phosphide/ZLL_Lights/Hardware/Standard/ZigbeeLightController_RevA1_bom.xlsx

Ref | Value | Footprint | Notes | Part number | Mouser reference
C1 | 1u | Capacitors_SMD:C_0805 | > 6V, X?R | GRM21BR71C105KA01L | 81-GRM40X105K16L
C2 | 1u | Capacitors_SMD:C_0805 | > 6V, X?R | GRM21BR71C105KA01L | 81-GRM40X105K16L
C3 | 100n | Capacitors_SMD:C_0603 | anything will do | 06033C104KAT2A | 581-06033C104KAT2A
C4 | 2.2u | Capacitors_SMD:C_1206 | > 40 V, X?R | UMK316B7225KL-T | 963-UMK316B7225KL-T
C5 | 10u | Capacitors_SMD:C_1206 | > 6V, X?R | GRM319R61E106KA12D | 81-GRM319R61E106KA2D
C6 | 100n | Capacitors_SMD:C_0603 | anything will do | 06033C104KAT2A | 581-06033C104KAT2A
C7 | 10u | Capacitors_SMD:C_1206 | > 6V, X?R | GRM319R61E106KA12D | 81-GRM319R61E106KA2D
C8 | 470n | Capacitors_SMD:C_0603 | anything will do | TMK107BJ474KA-T | 963-TMK107BJ474KA-T
C9 | 100n | Capacitors_SMD:C_0603 | anything will do | 06033C104KAT2A | 581-06033C104KAT2A
C10 | 100n | Capacitors_SMD:C_0603 | anything will do | 06033C104KAT2A | 581-06033C104KAT2A
C11 | 100n | Capacitors_SMD:C_0603 | anything will do | 06033C104KAT2A | 581-06033C104KAT2A
C12 | 100n | Capacitors_SMD:C_0603 | anything will do | 06033C104KAT2A | 581-06033C104KAT2A
C13 | 100n | Capacitors_SMD:C_0603 | anything will do | 06033C104KAT2A | 581-06033C104KAT2A
C14 | 100n | Capacitors_SMD:C_0603 | anything will do | 06033C104KAT2A | 581-06033C104KAT2A
C15 | 100n | Capacitors_SMD:C_0603 | anything will do | 06033C104KAT2A | 581-06033C104KAT2A
C16 | 100n | Capacitors_SMD:C_0603 | anything will do | 06033C104KAT2A | 581-06033C104KAT2A
C17 | 100n | Capacitors_SMD:C_0603 | anything will do | 06033C104KAT2A | 581-06033C104KAT2A
C18 | 100n | Capacitors_SMD:C_0603 | anything will do | 06033C104KAT2A | 581-06033C104KAT2A
C19 | 100n | Capacitors_SMD:C_0603 | anything will do | 06033C104KAT2A | 581-06033C104KAT2A
C20 | 100n | Capacitors_SMD:C_0603 | anything will do | 06033C104KAT2A | 581-06033C104KAT2A
C21 | 2.2u | Capacitors_SMD:C_1206 | > 40 V, X?R | UMK316B7225KL-T | 963-UMK316B7225KL-T
D1 | 1N4148 | Diodes_SMD:D_SOD-123 | any 1N4148 will do | 1N4148W-TP | 833-1N4148W-TP
D2 | NSR0340HT1G | Diodes_SMD:D_SOD-323 |  | NSR0340HT1G | 863-NSR0340HT1G
D3 | LED | zll_lib:D_0805_LED | can substitute, but may need to update R23 and footprint | LG R971-KN-1 | 720-LGR971-KN-1
D4 | SMAJ28A-E3/61 | Diodes_SMD:D_SMA |  | SMAJ28A-E3/61 | 625-SMAJ28A-E3
J1 | M20-7870346 | see datasheet |  | M20-7870346 | 855-M20-7870346
J2 | 1935268 | see datasheet |  | 1935268 | 651-1935268
J3 | 1935268 | see datasheet |  | 1935268 | 651-1935268
J4 | 1935161 | see datasheet |  | 1935161 | 651-1935161
L1 | 22u | Inductors_SMD:L_Taiyo-Yuden_NR-50xx |  | NRS5020T220MMGJ | 963-NRS5020T220MMGJ
Q1 | 2N7002 | TO_SOT_Packages_SMD:SOT-23 | anything will do | 2N7002P,215 | 771-2N7002P-215
Q2 | 2N7002 | TO_SOT_Packages_SMD:SOT-23 | anything will do | 2N7002P,215 | 771-2N7002P-215
Q3 | FDMS7682 | zll_lib:Power56_Vias |  | FDMS7682 | 512-FDMS7682
Q4 | FDMS7682 | zll_lib:Power56_Vias |  | FDMS7682 | 512-FDMS7682
Q5 | FDMS7682 | zll_lib:Power56_Vias |  | FDMS7682 | 512-FDMS7682
Q6 | FDMS7682 | zll_lib:Power56_Vias |  | FDMS7682 | 512-FDMS7682
Q7 | FDMS7682 | zll_lib:Power56_Vias |  | FDMS7682 | 512-FDMS7682
Q8 | FDMS7682 | zll_lib:Power56_Vias |  | FDMS7682 | 512-FDMS7682
Q9 | FDMS7682 | zll_lib:Power56_Vias |  | FDMS7682 | 512-FDMS7682
Q10 | FDMS7682 | zll_lib:Power56_Vias |  | FDMS7682 | 512-FDMS7682
Q11 | FDMS7682 | zll_lib:Power56_Vias |  | FDMS7682 | 512-FDMS7682
Q12 | FDMS7682 | zll_lib:Power56_Vias |  | FDMS7682 | 512-FDMS7682
Q13 | FDMS7682 | zll_lib:Power56_Vias |  | FDMS7682 | 512-FDMS7682
Q14 | FDMS7682 | zll_lib:Power56_Vias |  | FDMS7682 | 512-FDMS7682
R1 | 10k | Resistors_SMD:R_0603 | anything will do | RC0603FR-0710KL | 603-RC0603FR-0710KL
R2 | 10k | Resistors_SMD:R_0603 | anything will do | RC0603FR-0710KL | 603-RC0603FR-0710KL
R3 | 52.3k | Resistors_SMD:R_0603 | must be < 1% | AC0603FR-0752K3L | 603-AC0603FR-0752K3L
R4 | 10k | Resistors_SMD:R_0603 | must be < 1% | RC0603FR-0710KL | 603-RC0603FR-0710KL
R5 | 4.7k | Resistors_SMD:R_0603 | anything will do | RC0603JR-074K7L | 603-RC0603JR-074K7L
R6 | 4.7k | Resistors_SMD:R_0603 | anything will do | RC0603JR-074K7L | 603-RC0603JR-074K7L
R7 | 18k | Resistors_SMD:R_0603 | anything will do | RC0603JR-0718KL | 603-RC0603JR-0718KL
R8 | 4.7k | Resistors_SMD:R_0603 | anything will do | RC0603JR-074K7L | 603-RC0603JR-074K7L
R9 | 4.7k | Resistors_SMD:R_0603 | anything will do | RC0603JR-074K7L | 603-RC0603JR-074K7L
R10 | 8.2 | Resistors_SMD:R_0603 | anything will do | RC0603JR-078R2L | 603-RC0603JR-078R2L
R11 | 8.2 | Resistors_SMD:R_0603 | anything will do | RC0603JR-078R2L | 603-RC0603JR-078R2L
R12 | 8.2 | Resistors_SMD:R_0603 | anything will do | RC0603JR-078R2L | 603-RC0603JR-078R2L
R13 | 8.2 | Resistors_SMD:R_0603 | anything will do | RC0603JR-078R2L | 603-RC0603JR-078R2L
R14 | 8.2 | Resistors_SMD:R_0603 | anything will do | RC0603JR-078R2L | 603-RC0603JR-078R2L
R15 | 8.2 | Resistors_SMD:R_0603 | anything will do | RC0603JR-078R2L | 603-RC0603JR-078R2L
R16 | 8.2 | Resistors_SMD:R_0603 | anything will do | RC0603JR-078R2L | 603-RC0603JR-078R2L
R17 | 8.2 | Resistors_SMD:R_0603 | anything will do | RC0603JR-078R2L | 603-RC0603JR-078R2L
R18 | 8.2 | Resistors_SMD:R_0603 | anything will do | RC0603JR-078R2L | 603-RC0603JR-078R2L
R19 | 8.2 | Resistors_SMD:R_0603 | anything will do | RC0603JR-078R2L | 603-RC0603JR-078R2L
R20 | 8.2 | Resistors_SMD:R_0603 | anything will do | RC0603JR-078R2L | 603-RC0603JR-078R2L
R21 | 8.2 | Resistors_SMD:R_0603 | anything will do | RC0603JR-078R2L | 603-RC0603JR-078R2L
R22 | 10k | Resistors_SMD:R_0603 | anything will do | RC0603FR-0710KL | 603-RC0603FR-0710KL
R23 | 330 | Resistors_SMD:R_0603 | anything will do | RC0603JR-07330RL | 603-RC0603JR-07330RL
R24 | 10k | Resistors_SMD:R_0603 | anything will do | RC0603FR-0710KL | 603-RC0603FR-0710KL
R25 | 10k | Resistors_SMD:R_0603 | anything will do | RC0603FR-0710KL | 603-RC0603FR-0710KL
R26 | 10k | Resistors_SMD:R_0603 | anything will do | RC0603FR-0710KL | 603-RC0603FR-0710KL
R27 | 10k | Resistors_SMD:R_0603 | anything will do | RC0603FR-0710KL | 603-RC0603FR-0710KL
R28 | 10k | Resistors_SMD:R_0603 | anything will do | RC0603FR-0710KL | 603-RC0603FR-0710KL
R29 | 10k | Resistors_SMD:R_0603 | anything will do | RC0603FR-0710KL | 603-RC0603FR-0710KL
R30 | 10k | Resistors_SMD:R_0603 | anything will do | RC0603FR-0710KL | 603-RC0603FR-0710KL
R31 | 10k | Resistors_SMD:R_0603 | anything will do | RC0603FR-0710KL | 603-RC0603FR-0710KL
R32 | 10k | Resistors_SMD:R_0603 | anything will do | RC0603FR-0710KL | 603-RC0603FR-0710KL
R33 | 10k | Resistors_SMD:R_0603 | anything will do | RC0603FR-0710KL | 603-RC0603FR-0710KL
R34 | 10k | Resistors_SMD:R_0603 | anything will do | RC0603FR-0710KL | 603-RC0603FR-0710KL
R35 | 10k | Resistors_SMD:R_0603 | anything will do | RC0603FR-0710KL | 603-RC0603FR-0710KL
SW1 | SW_Push | zll_lib:PTS645SM43SMTR_92_LFS | can substitute, but may need to update footprint | PTS645SM43SMTR 92 LFS | 611-PTS645SM43SMTR92
TH1 | NTCG163JH103JT1 | Resistors_SMD:R_0603 | can substitute, but may need to update calibration in firmware | NTCG163JH103JT1 | 810-NTCG163JH103JT1
U1 | MCP16301 | TO_SOT_Packages_SMD:SOT-23-6 |  | MCP16301 | 579-MCP16301HT-E/CH
U2 | AP2120N-3.3 | TO_SOT_Packages_SMD:SOT-23 |  | AP2120N-3.3TRG1 | 621-AP2120N-3.3TRG1
U3 | JN5168-001-M00 | zll_lib:JN5168-001 |  | JN5168-001-M00Z | 771-JN5168-001-M00Z
U4 | PCA9685 | zll_lib:TSSOP-28 |  | PCA9685PW,118 | 771-PCA9685PW,118
U5 | ZXGD3009DY | TO_SOT_Packages_SMD:SOT-363_SC-70-6 |  | ZXGD3009DYTA | 621-ZXGD3009DYTA
U6 | ZXGD3009DY | TO_SOT_Packages_SMD:SOT-363_SC-70-6 |  | ZXGD3009DYTA | 621-ZXGD3009DYTA
U7 | ZXGD3009DY | TO_SOT_Packages_SMD:SOT-363_SC-70-6 |  | ZXGD3009DYTA | 621-ZXGD3009DYTA
U8 | ZXGD3009DY | TO_SOT_Packages_SMD:SOT-363_SC-70-6 |  | ZXGD3009DYTA | 621-ZXGD3009DYTA
U9 | ZXGD3009DY | TO_SOT_Packages_SMD:SOT-363_SC-70-6 |  | ZXGD3009DYTA | 621-ZXGD3009DYTA
U10 | ZXGD3009DY | TO_SOT_Packages_SMD:SOT-363_SC-70-6 |  | ZXGD3009DYTA | 621-ZXGD3009DYTA
U11 | ZXGD3009DY | TO_SOT_Packages_SMD:SOT-363_SC-70-6 |  | ZXGD3009DYTA | 621-ZXGD3009DYTA
U12 | ZXGD3009DY | TO_SOT_Packages_SMD:SOT-363_SC-70-6 |  | ZXGD3009DYTA | 621-ZXGD3009DYTA
U13 | ZXGD3009DY | TO_SOT_Packages_SMD:SOT-363_SC-70-6 |  | ZXGD3009DYTA | 621-ZXGD3009DYTA
U14 | ZXGD3009DY | TO_SOT_Packages_SMD:SOT-363_SC-70-6 |  | ZXGD3009DYTA | 621-ZXGD3009DYTA
U15 | ZXGD3009DY | TO_SOT_Packages_SMD:SOT-363_SC-70-6 |  | ZXGD3009DYTA | 621-ZXGD3009DYTA
U16 | ZXGD3009DY | TO_SOT_Packages_SMD:SOT-363_SC-70-6 |  | ZXGD3009DYTA | 621-ZXGD3009DYTA
