phosphide/ZLL_Lights/Hardware/Standard/ZigbeeLightController.kicad_pcb

## KiCad design Hardware/Standard/ZigbeeLightController.kicad_pcb (2018-05-30)

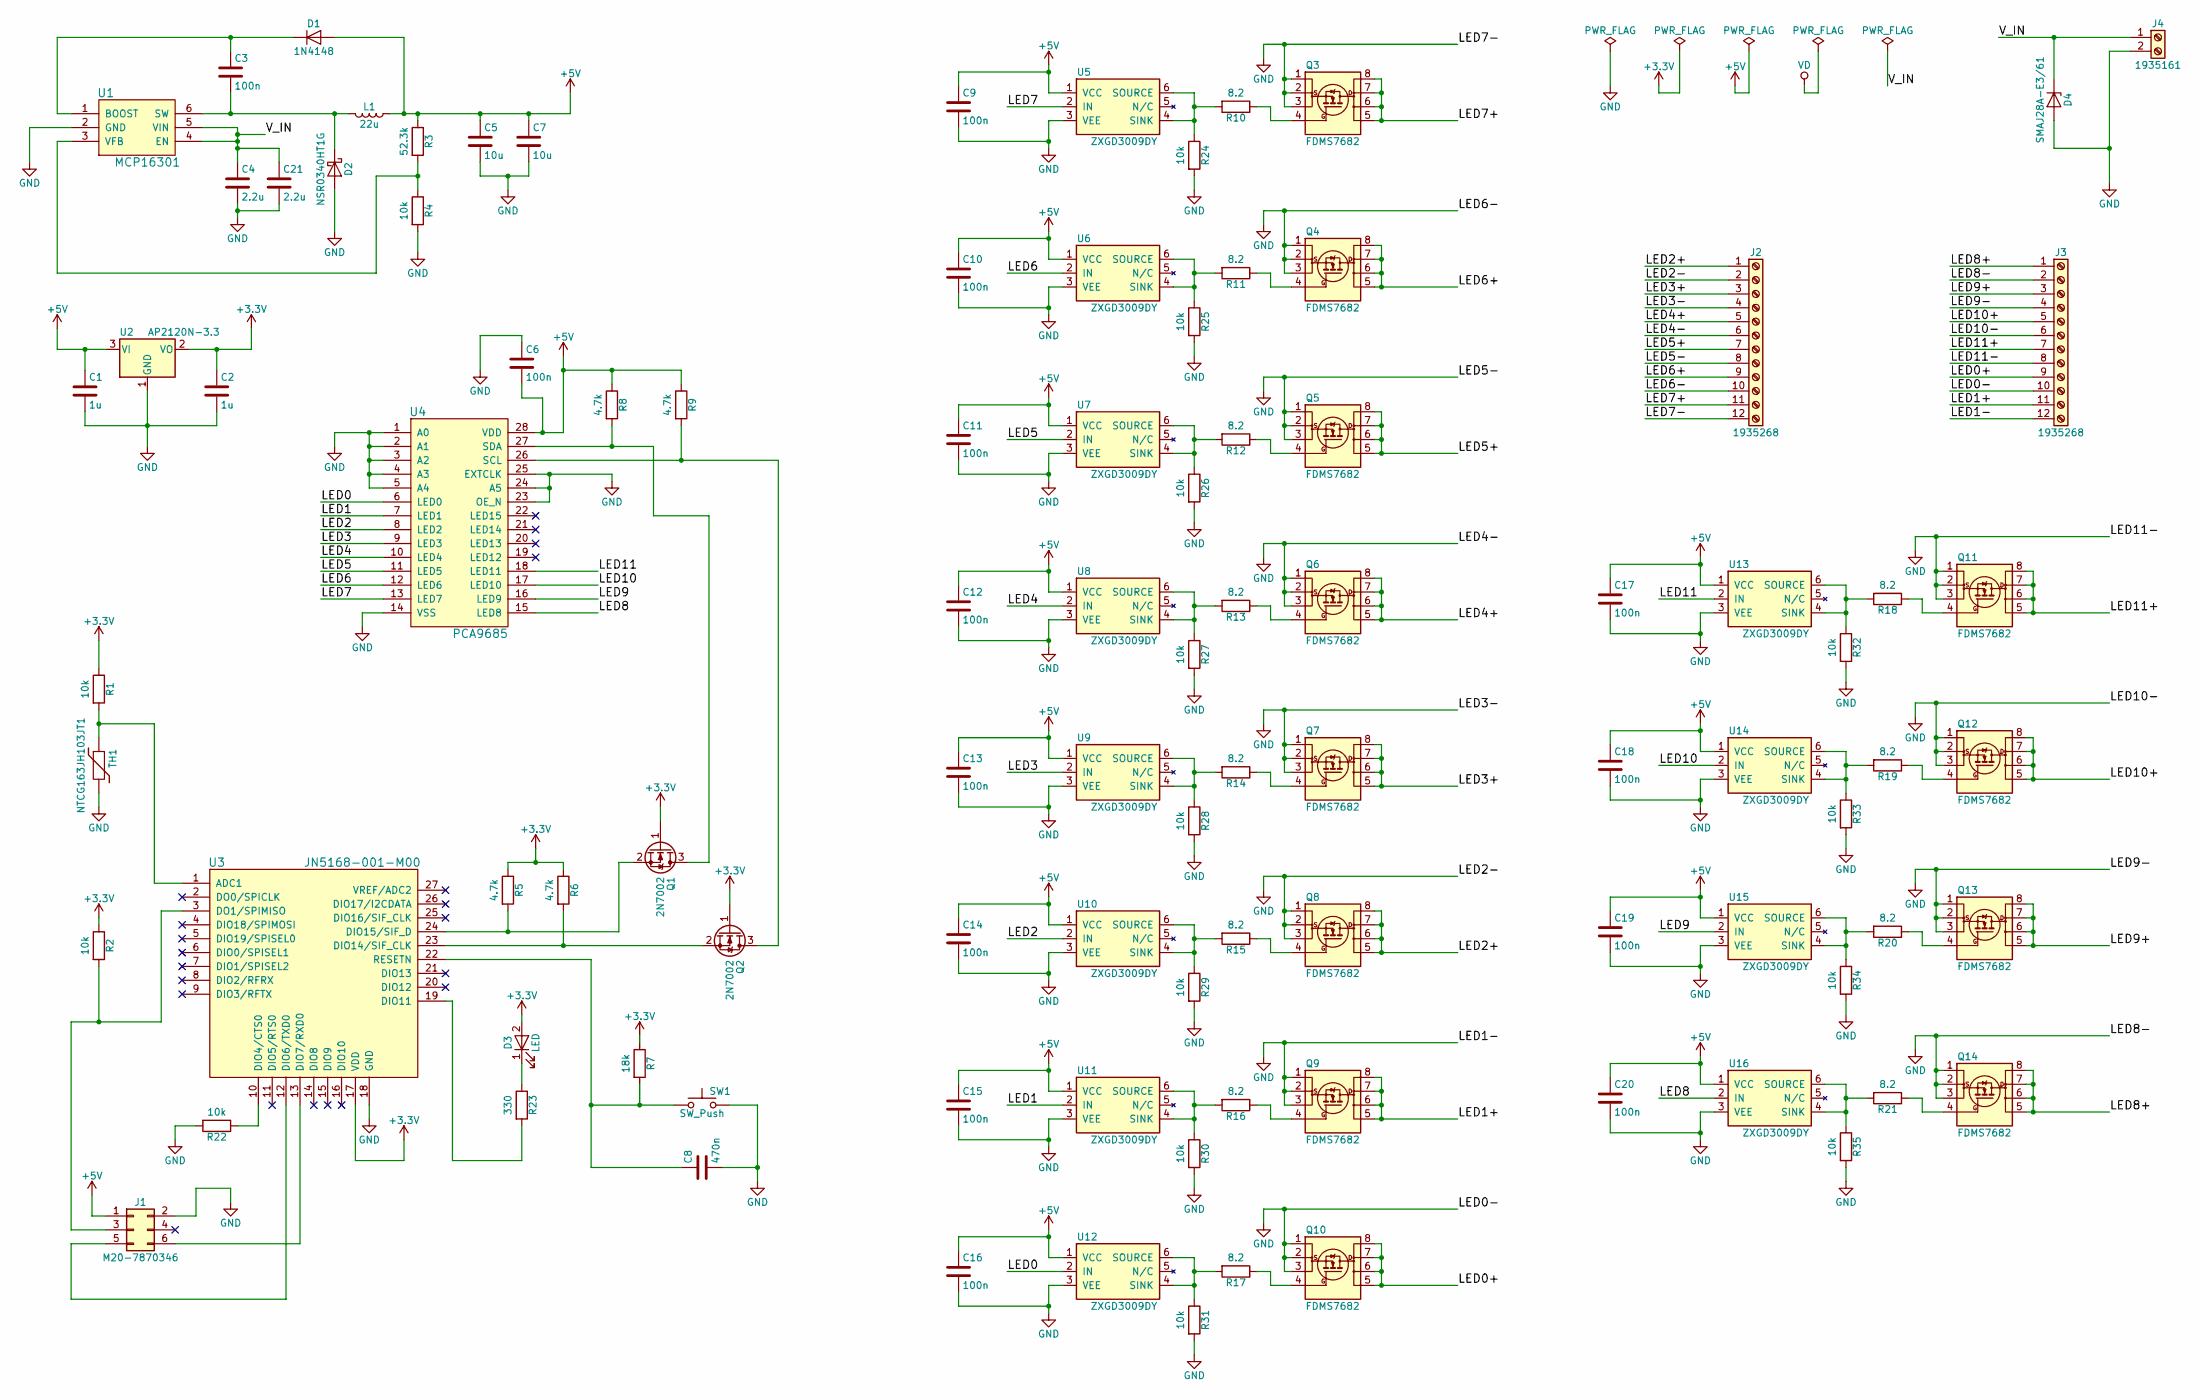
[picture p1: schematic ZigbeeLightController.sch, Zigbee Light Controller]

Parts:
C1, C2: 1u; C_0805
C3, C6, C9, C10, C11, C12, C13, C14, C15, C16, C17, C18, C19, C20: 100n; C_0603
C4, C21: 2.2u; C_1206
C5, C7: 10u; C_1206
C8: 470n; C_0603
D1: 1N4148; D_SOD-123
D2: NSR0340HT1G; D_SOD-323
D3: LED; D_0805_LED
D4: SMAJ28A-E3/61; D_SMA
J1: M20-7870346; Pin_Header_Straight_2x03_Pitch2.54mm_SMD
J2, J3: 1935268; TerminalBlock_Philmore_TB13x_12x5mm_Straight
J4: 1935161; TerminalBlock_Philmore_TB132_02x5mm_Straight
L1: 22u; L_Taiyo-Yuden_NR-50xx
Q1, Q2: 2N7002; SOT-23
Q3, Q4, Q5, Q6, Q7, Q8, Q9, Q10, Q11, Q12, Q13, Q14: FDMS7682; Power56_Vias
R1, R2, R4, R22, R24, R25, R26, R27, R28, R29, R30, R31, R32, R33, R34, R35: 10k; R_0603
R3: 52.3k; R_0603
R5, R6, R8, R9: 4.7k; R_0603
R7: 18k; R_0603
R10, R11, R12, R13, R14, R15, R16, R17, R18, R19, R20, R21: 8.2; R_0603
R23: 330; R_0603
SW1: SW_Push; PTS645SM43SMTR_92_LFS
TH1: NTCG163JH103JT1; R_0603
U1: MCP16301; SOT-23-6
U2: AP2120N-3.3; SOT-23
U3: JN5168-001-M00; JN5168-001
U4: PCA9685; TSSOP-28
U5, U6, U7, U8, U9, U10, U11, U12, U13, U14, U15, U16: ZXGD3009DY; SOT-363_SC-70-6

Connections:
+3V3: C2.1, D3.2 (A), Q1.1 (G), Q2.1 (G), R1.1, R2.1, R5.1, R6.1, R7.1, U2.2 (VO), U3.17 (VDD); also elsewhere on the board
+5V: C1.1, C5.1, C6.2, C7.1, C9.1, C10.1, C11.1, C12.1, C13.1, C14.1, C15.1, C16.1, C17.1, C18.1, C19.1, C20.1, D1.2 (A), J1.1, L1.1, R3.1, R8.1, R9.1, U2.3 (VI), U4.28 (VDD), U5.1 (VCC), U6.1 (VCC), U7.1 (VCC), U8.1 (VCC), U9.1 (VCC), U10.1 (VCC), U11.1 (VCC), U12.1 (VCC), U13.1 (VCC), U14.1 (VCC), U15.1 (VCC), U16.1 (VCC); also elsewhere on the board
/LED0: U4.6 (LED0), U12.2 (IN)
/LED0+: J3.9, Q10.5 (D), Q10.6 (D), Q10.7 (D), Q10.8 (D)
/LED1: U4.7 (LED1), U11.2 (IN)
/LED1+: J3.11, Q9.5 (D), Q9.6 (D), Q9.7 (D), Q9.8 (D)
/LED2: U4.8 (LED2), U10.2 (IN)
/LED2+: J2.1, Q8.5 (D), Q8.6 (D), Q8.7 (D), Q8.8 (D)
/LED3: U4.9 (LED3), U9.2 (IN)
/LED3+: J2.3, Q7.5 (D), Q7.6 (D), Q7.7 (D), Q7.8 (D)
/LED4: U4.10 (LED4), U8.2 (IN)
/LED4+: J2.5, Q6.5 (D), Q6.6 (D), Q6.7 (D), Q6.8 (D)
/LED5: U4.11 (LED5), U7.2 (IN)
/LED5+: J2.7, Q5.5 (D), Q5.6 (D), Q5.7 (D), Q5.8 (D)
/LED6: U4.12 (LED6), U6.2 (IN)
/LED6+: J2.9, Q4.5 (D), Q4.6 (D), Q4.7 (D), Q4.8 (D)
/LED7: U4.13 (LED7), U5.2 (IN); also elsewhere on the board
/LED7+: J2.11, Q3.5 (D), Q3.6 (D), Q3.7 (D), Q3.8 (D)
/LED8: U4.15 (LED8), U16.2 (IN)
/LED8+: J3.1, Q14.5 (D), Q14.6 (D), Q14.7 (D), Q14.8 (D)
/LED9: U4.16 (LED9), U15.2 (IN); also elsewhere on the board
/LED9+: J3.3, Q13.5 (D), Q13.6 (D), Q13.7 (D), Q13.8 (D)
/LED10: U4.17 (LED10), U14.2 (IN)
/LED10+: J3.5, Q12.5 (D), Q12.6 (D), Q12.7 (D), Q12.8 (D)
/LED11: U4.18 (LED11), U13.2 (IN)
/LED11+: J3.7, Q11.5 (D), Q11.6 (D), Q11.7 (D), Q11.8 (D)
/V_IN: C4.1, C21.1, D4.1 (K), J4.1, U1.4 (EN), U1.5 (VIN)
GND: C1.2, C2.2, C4.2, C5.2, C6.1, C7.2, C8.2, C9.2, C10.2, C11.2, C12.2, C13.2, C14.2, C15.2, C16.2, C17.2, C18.2, C19.2, C20.2, C21.2, D2.2 (A), D4.2 (A), J1.2, J2.2, J2.4, J2.6, J2.8, J2.10, J2.12, J3.2, J3.4, J3.6, J3.8, J3.10, J3.12, J4.2, Q3.1 (S), Q3.2 (S), Q3.3 (S), Q4.1 (S), Q4.2 (S), Q4.3 (S), Q5.1 (S), Q5.2 (S), Q5.3 (S), Q6.1 (S), Q6.2 (S), Q6.3 (S), Q7.1 (S), Q7.2 (S), Q7.3 (S), Q8.1 (S), Q8.2 (S), Q8.3 (S), Q9.1 (S), Q9.2 (S), Q9.3 (S), Q10.1 (S), Q10.2 (S), Q10.3 (S), Q11.1 (S), Q11.2 (S), Q11.3 (S), Q12.1 (S), Q12.2 (S), Q12.3 (S), Q13.1 (S), Q13.2 (S), Q13.3 (S), Q14.1 (S), Q14.2 (S), Q14.3 (S), R4.2, R22.2, R24.2, R25.2, R26.2, R27.2, R28.2, R29.2, R30.2, R31.2, R32.2, R33.2, R34.2, R35.2, SW1.2, TH1.2, U1.2 (GND), U2.1 (GND), U3.18 (GND), U4.1 (A0), U4.2 (A1), U4.3 (A2), U4.4 (A3), U4.5 (A4), U4.14 (VSS), U4.23 (OE_N), U4.24 (A5), U4.25 (EXTCLK), U5.3 (VEE), U6.3 (VEE), U7.3 (VEE), U8.3 (VEE), U9.3 (VEE), U10.3 (VEE), U11.3 (VEE), U12.3 (VEE), U13.3 (VEE), U14.3 (VEE), U15.3 (VEE), U16.3 (VEE); also elsewhere on the board
unnamed: C3.1, D1.1 (K), U1.1 (BOOST)
unnamed: C3.2, D2.1 (K), L1.2, U1.6 (SW)
unnamed: C8.1, R7.2, SW1.1, U3.22 (RESETN)
unnamed: D3.1 (K), R23.1
unnamed: J1.3, R2.2, U3.3 (DO1/SPIMISO)
unnamed: J1.5, U3.12 (DIO6/TXD0)
unnamed: J1.6, U3.13 (DIO7/RXD0)
unnamed: Q1.2 (S), R5.2, U3.24 (DIO15/SIF_D)
unnamed 37: Q1.3 (D), R8.2, U4.27 (SDA); also elsewhere on the board
unnamed: Q2.2 (S), R6.2, U3.23 (DIO14/SIF_CLK)
unnamed 39: Q2.3 (D), R9.2, U4.26 (SCL); also elsewhere on the board
unnamed: Q3.4 (G), R10.1
unnamed: Q4.4 (G), R11.1
unnamed: Q5.4 (G), R12.1
unnamed: Q6.4 (G), R13.1
unnamed: Q7.4 (G), R14.1
unnamed: Q8.4 (G), R15.1
unnamed: Q9.4 (G), R16.1
unnamed: Q10.4 (G), R17.1
unnamed: Q11.4 (G), R18.1
unnamed: Q12.4 (G), R19.1
unnamed: Q13.4 (G), R20.1
unnamed: Q14.4 (G), R21.1
unnamed: R1.2, TH1.1, U3.1 (ADC1)
unnamed: R3.2, R4.1, U1.3 (VFB)
unnamed: R10.2, R24.1, U5.4 (SINK), U5.6 (SOURCE)
unnamed: R11.2, R25.1, U6.4 (SINK), U6.6 (SOURCE)
unnamed: R12.2, R26.1, U7.4 (SINK), U7.6 (SOURCE)
unnamed: R13.2, R27.1, U8.4 (SINK), U8.6 (SOURCE)
unnamed: R14.2, R28.1, U9.4 (SINK), U9.6 (SOURCE)
unnamed: R15.2, R29.1, U10.4 (SINK), U10.6 (SOURCE)
unnamed: R16.2, R30.1, U11.4 (SINK), U11.6 (SOURCE)
unnamed: R17.2, R31.1, U12.4 (SINK), U12.6 (SOURCE)
unnamed: R18.2, R32.1, U13.4 (SINK), U13.6 (SOURCE)
unnamed: R19.2, R33.1, U14.4 (SINK), U14.6 (SOURCE)
unnamed: R20.2, R34.1, U15.4 (SINK), U15.6 (SOURCE)
unnamed: R21.2, R35.1, U16.4 (SINK), U16.6 (SOURCE)
unnamed: R22.1, U3.10 (DIO4/CTS0)
unnamed: R23.2, U3.19 (DIO11)

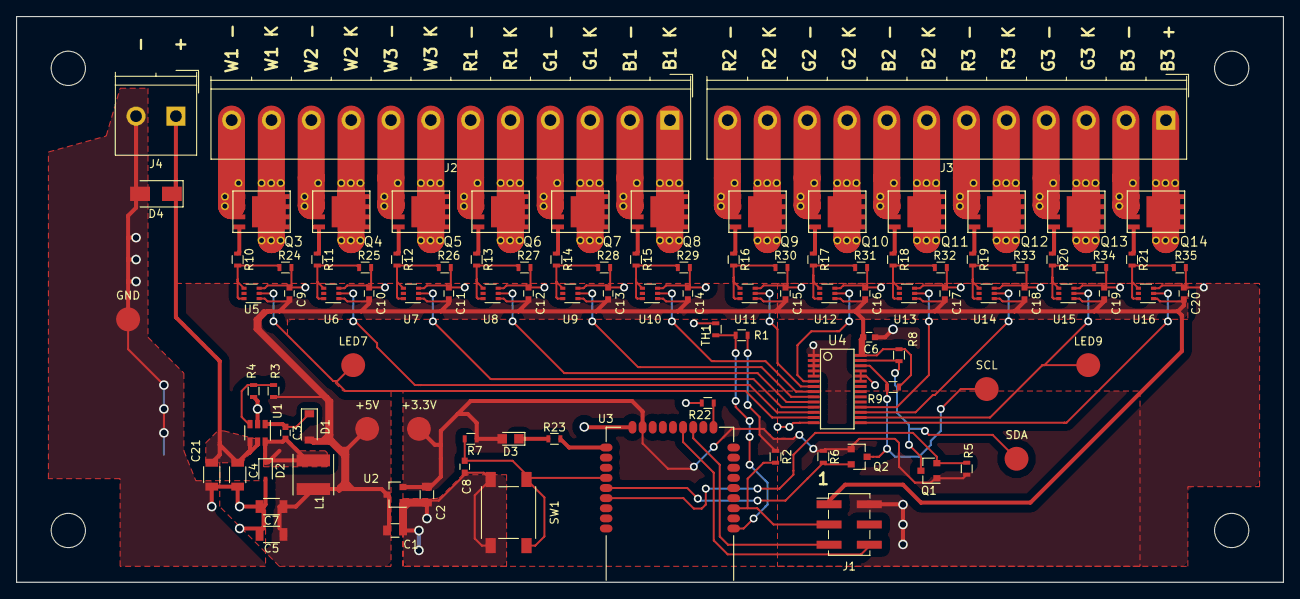
[picture p2: board ZigbeeLightController.kicad_pcb from above]

Board: 2 copper layers, 159.0 x 71.0 mm, 104 parts (0 on the bottom side), 67 nets.

Other parts of the board:
+3.3V, +5V: Measurement_Point_Round-SMD-Pad_Big
GND: Measurement_Point_Round-SMD-Pad_Big
LED7, LED9: Measurement_Point_Round-SMD-Pad_Big
SCL: Measurement_Point_Round-SMD-Pad_Big
SDA: Measurement_Point_Round-SMD-Pad_Big

Their connections:
+3V3: +3.3V.1; also elsewhere on the board
+5V: +5V.1; also elsewhere on the board
/LED7: LED7.1; also elsewhere on the board
/LED9: LED9.1; also elsewhere on the board
GND: GND.1; also elsewhere on the board
unnamed 37: SDA.1; also elsewhere on the board
unnamed 39: SCL.1; also elsewhere on the board
