phosphide/ZLL_Lights/Hardware/Mini/ZigbeeLightControllerMini.kicad_pcb

## KiCad design Hardware/Mini/ZigbeeLightControllerMini.kicad_pcb (2018-05-30)

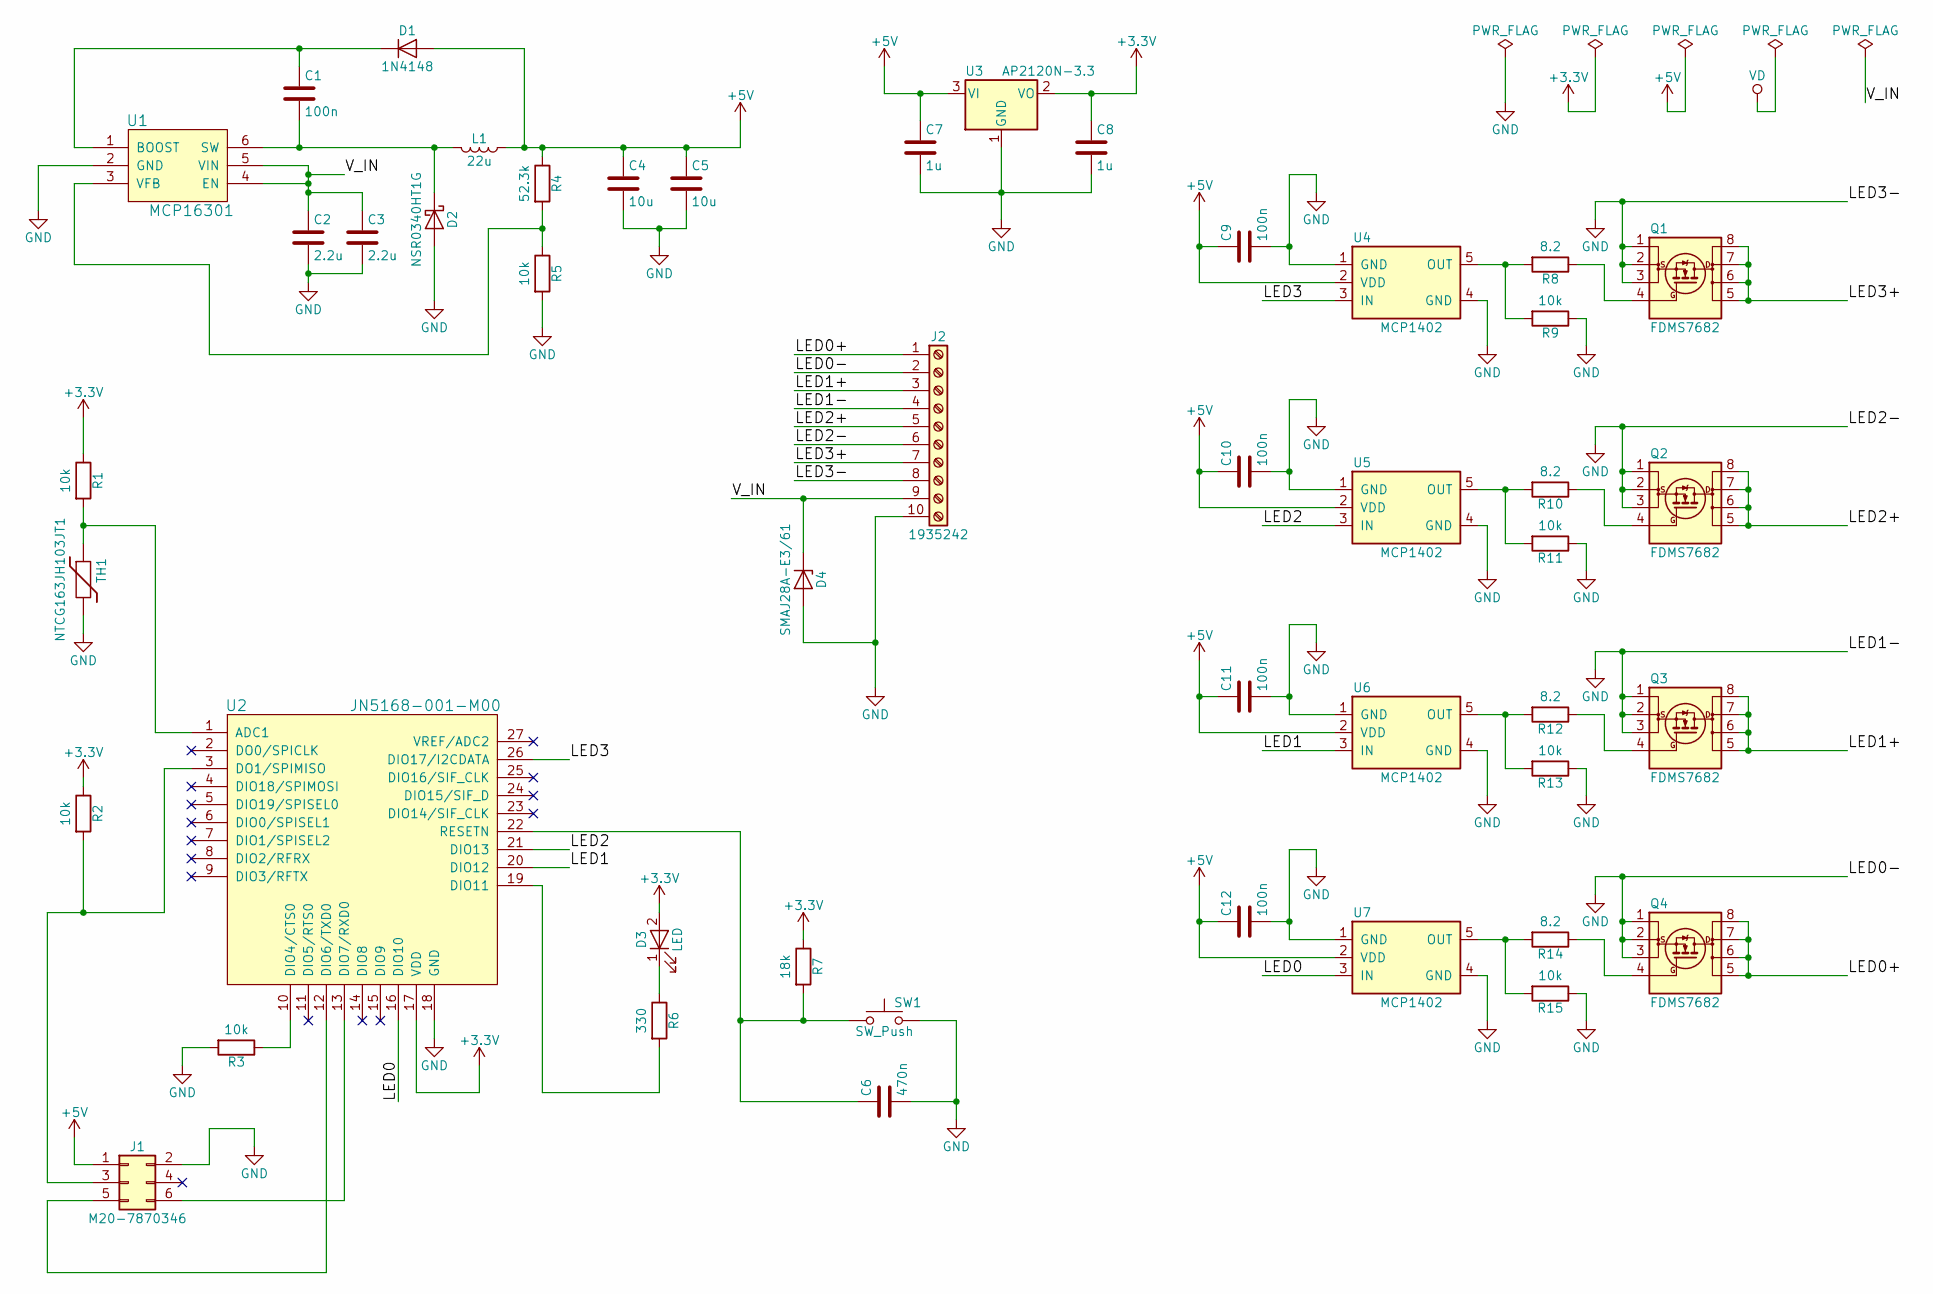
[picture p3: schematic ZigbeeLightControllerMini.sch, Zigbee Light Controller]

Parts:
C1, C9, C10, C11, C12: 100n; C_0603
C2, C3: 2.2u; C_1206
C4, C5: 10u; C_1206
C6: 470n; C_0603
C7, C8: 1u; C_0805
D1: 1N4148; D_SOD-123
D2: NSR0340HT1G; D_SOD-323
D3: LED; D_0805_LED
D4: SMAJ28A-E3/61; D_SMA
J1: M20-7870346; Pin_Header_Straight_2x03_Pitch2.54mm_SMD
J2: 1935242; TerminalBlock_Phoenix_MKDS1.5-10pol
L1: 22u; L_Taiyo-Yuden_NR-50xx
Q1, Q2, Q3, Q4: FDMS7682; Power56_Vias
R1, R2, R3, R5, R9, R11, R13, R15: 10k; R_0603
R4: 52.3k; R_0603
R6: 330; R_0603
R7: 18k; R_0603
R8, R10, R12, R14: 8.2; R_0603
SW1: SW_Push; PTS645SM43SMTR_92_LFS
TH1: NTCG163JH103JT1; R_0603
U1: MCP16301; SOT-23-6
U2: JN5168-001-M00; JN5168-001
U3: AP2120N-3.3; SOT-23
U4, U5, U6, U7: MCP1402; SOT-23-5

Connections:
+3V3: C8.1, D3.2 (A), R1.1, R2.1, R7.1, U2.17 (VDD), U3.2 (VO); also elsewhere on the board
+5V: C4.1, C5.1, C7.1, C9.1, C10.1, C11.1, C12.1, D1.2 (A), J1.1, L1.1, R4.1, U3.3 (VI), U4.2 (VDD), U5.2 (VDD), U6.2 (VDD), U7.2 (VDD); also elsewhere on the board
/LED0: U2.16 (DIO10), U7.3 (IN)
/LED0+: J2.1, Q4.5 (D), Q4.6 (D), Q4.7 (D), Q4.8 (D)
/LED1: U2.20 (DIO12), U6.3 (IN)
/LED1+: J2.3, Q3.5 (D), Q3.6 (D), Q3.7 (D), Q3.8 (D)
/LED2: U2.21 (DIO13), U5.3 (IN)
/LED2+: J2.5, Q2.5 (D), Q2.6 (D), Q2.7 (D), Q2.8 (D)
/LED3: U2.26 (DIO17/I2CDATA), U4.3 (IN)
/LED3+: J2.7, Q1.5 (D), Q1.6 (D), Q1.7 (D), Q1.8 (D)
/V_IN: C2.1, C3.1, D4.1 (K), J2.9, U1.4 (EN), U1.5 (VIN)
GND: C2.2, C3.2, C4.2, C5.2, C6.2, C7.2, C8.2, C9.2, C10.2, C11.2, C12.2, D2.2 (A), D4.2 (A), J1.2, J2.2, J2.4, J2.6, J2.8, J2.10, Q1.1 (S), Q1.2 (S), Q1.3 (S), Q2.1 (S), Q2.2 (S), Q2.3 (S), Q3.1 (S), Q3.2 (S), Q3.3 (S), Q4.1 (S), Q4.2 (S), Q4.3 (S), R3.2, R5.2, R9.1, R11.1, R13.1, R15.1, SW1.2, TH1.2, U1.2 (GND), U2.18 (GND), U3.1 (GND), U4.1 (GND), U4.4 (GND), U5.1 (GND), U5.4 (GND), U6.1 (GND), U6.4 (GND), U7.1 (GND), U7.4 (GND)
unnamed: C1.1, D1.1 (K), U1.1 (BOOST)
unnamed: C1.2, D2.1 (K), L1.2, U1.6 (SW)
unnamed: C6.1, R7.2, SW1.1, U2.22 (RESETN)
unnamed: D3.1 (K), R6.1
unnamed: J1.3, R2.2, U2.3 (DO1/SPIMISO)
unnamed: J1.5, U2.12 (DIO6/TXD0)
unnamed: J1.6, U2.13 (DIO7/RXD0)
unnamed: Q1.4 (G), R8.1
unnamed: Q2.4 (G), R10.1
unnamed: Q3.4 (G), R12.1
unnamed: Q4.4 (G), R14.1
unnamed: R1.2, TH1.1, U2.1 (ADC1)
unnamed: R3.1, U2.10 (DIO4/CTS0)
unnamed: R4.2, R5.1, U1.3 (VFB)
unnamed: R6.2, U2.19 (DIO11)
unnamed: R8.2, R9.2, U4.5 (OUT)
unnamed: R10.2, R11.2, U5.5 (OUT)
unnamed: R12.2, R13.2, U6.5 (OUT)
unnamed: R14.2, R15.2, U7.5 (OUT)

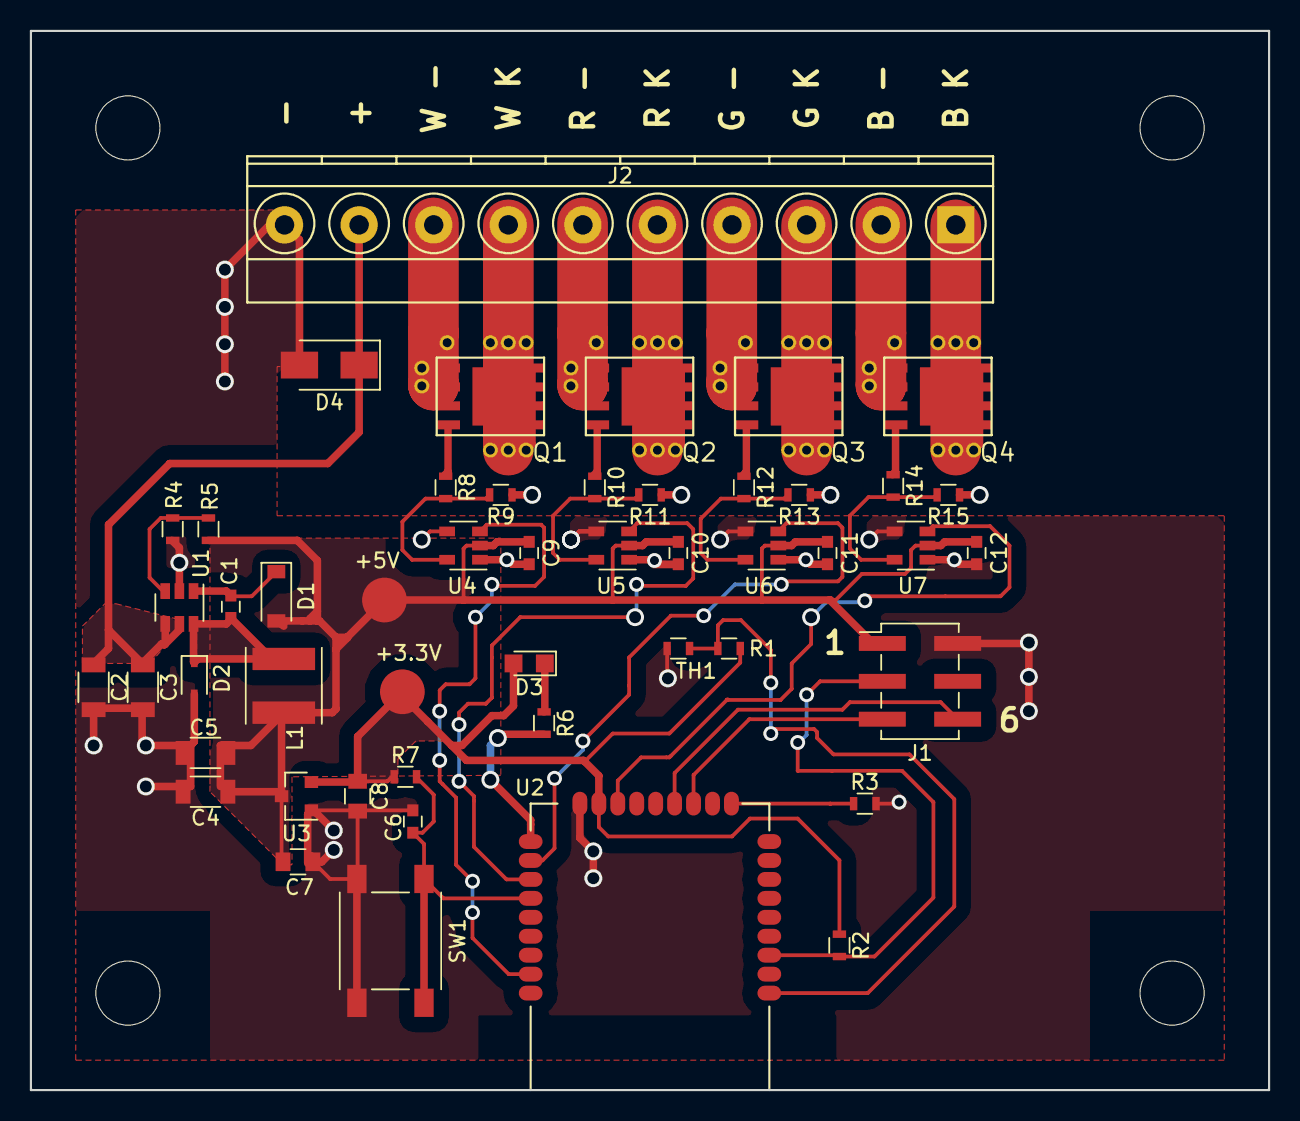
[picture p4: board ZigbeeLightControllerMini.kicad_pcb from above]

Board: 2 copper layers, 83.0 x 71.0 mm, 49 parts (0 on the bottom side), 31 nets.

Other parts of the board:
+3.3V, +5V: Measurement_Point_Round-SMD-Pad_Big

Their connections:
+3V3: +3.3V.1; also elsewhere on the board
+5V: +5V.1; also elsewhere on the board
