phosphide/ZLL_Lights/Common_Light/Source/app_light_interpolation.c

/*****************************************************************************
 *
 * MODULE:             JN-AN-1171
 *
 * COMPONENT:          app_light_interpolation.c
 *
 * DESCRIPTION:        ZLL/ZHA Demo: ZCL Linear Interpolation - Implementation
 *
 *
 ****************************************************************************
 *
 * This software is owned by NXP B.V. and/or its supplier and is protected
 * under applicable copyright laws. All rights are reserved. We grant You,
 * and any third parties, a license to use this software solely and
 * exclusively on NXP products [NXP Microcontrollers such as JN5168, JN5164,
 * JN5161, JN5148, JN5142, JN5139].
 * You, and any third parties must reproduce the copyright and warranty notice
 * and any other legend of ownership on each copy or partial copy of the
 * software.
 *
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
 * Copyright NXP B.V. 2014. All rights reserved
 *
 ***************************************************************************/

/****************************************************************************/
/***        Include files                                                 ***/
/****************************************************************************/
#include <jendefs.h>
#include "app_light_interpolation.h"
#include "DriverBulb.h"

/****************************************************************************/
/***        Macro Definitions                                             ***/
/****************************************************************************/
#define INTPOINTS	(10)
#define SCALE 		(7)

/****************************************************************************/
/***        Type Definitions                                              ***/
/****************************************************************************/
typedef struct
{
	uint32 u32Current;
	uint32 u32Target;
	int32  i32Delta;
}tsLI_Params;

typedef struct
{
	tsLI_Params sLevel;
	tsLI_Params sRed;
	tsLI_Params sGreen;
	tsLI_Params sBlue;
	tsLI_Params sColTemp;
	uint32      u32PointsAdded;

}tsLI_Vars;

/****************************************************************************/
/***        Local Function Prototypes                                     ***/
/****************************************************************************/

PRIVATE void vLI_InitVar(tsLI_Params *psLI_Params, uint32 u32NewTarget);
PRIVATE uint32  u32divu10(uint32 n);

/****************************************************************************/
/*          Exported Variables                                              */
/****************************************************************************/

/****************************************************************************/
/***        Local Variables                                               ***/
/****************************************************************************/

PRIVATE tsLI_Vars sLI_Vars[NUM_BULBS];

/****************************************************************************/
/***        Exported Functions                                            ***/
/****************************************************************************/

/****************************************************************************
 * NAME: vLI_SetCurrentValues
 *
 * DESCRIPTION:
 * Sets the current interpolation values
 ****************************************************************************/
PUBLIC void vLI_SetCurrentValues(uint8 u8Bulb, uint32 u32Level, uint32 u32Red, uint32 u32Green, uint32 u32Blue, uint32 u32ColTemp)
{
	sLI_Vars[u8Bulb].sLevel.u32Current   += u32Level   << SCALE;
	sLI_Vars[u8Bulb].sRed.u32Current     += u32Red     << SCALE;
	sLI_Vars[u8Bulb].sGreen.u32Current   += u32Blue    << SCALE;
    sLI_Vars[u8Bulb].sBlue.u32Current    += u32Green   << SCALE;
    sLI_Vars[u8Bulb].sColTemp.u32Current += u32ColTemp << SCALE;

}

/****************************************************************************
 * NAME: vLI_Start
 *
 * DESCRIPTION:
 * Starts the linear interpolation process between successive ZCL updates
 ****************************************************************************/
PUBLIC void vLI_Start(uint8 u8Bulb, uint32 u32Level, uint32 u32Red, uint32 u32Green, uint32 u32Blue, uint32 u32ColTemp)
{
	vLI_InitVar(&(sLI_Vars[u8Bulb].sLevel),    u32Level);
	vLI_InitVar(&(sLI_Vars[u8Bulb].sRed),      u32Red);
	vLI_InitVar(&(sLI_Vars[u8Bulb].sGreen),    u32Green);
    vLI_InitVar(&(sLI_Vars[u8Bulb].sBlue),     u32Blue);
    vLI_InitVar(&(sLI_Vars[u8Bulb].sColTemp),  u32ColTemp);
    vLI_UpdateDriver(u8Bulb);
    sLI_Vars[u8Bulb].u32PointsAdded  = 1;
}

PUBLIC void vLI_Stop(uint8 u8Bulb)
{
    sLI_Vars[u8Bulb].u32PointsAdded = INTPOINTS;
}

/****************************************************************************
 * NAME: vLI_CreatePoints
 *
 * DESCRIPTION:
 * Provides multiple LI points in time/value pairs between
 * successive  ZCL updates.  This provides smooth 100Hz updates
 * on colour and level transitions
 ****************************************************************************/
PUBLIC void vLI_CreatePoints(uint8 u8Bulb)
{
    if (sLI_Vars[u8Bulb].u32PointsAdded < INTPOINTS)
    {
    	sLI_Vars[u8Bulb].u32PointsAdded++;
        sLI_Vars[u8Bulb].sLevel.u32Current   += sLI_Vars[u8Bulb].sLevel.i32Delta;
        sLI_Vars[u8Bulb].sRed.u32Current     += sLI_Vars[u8Bulb].sRed.i32Delta;
        sLI_Vars[u8Bulb].sGreen.u32Current   += sLI_Vars[u8Bulb].sGreen.i32Delta;
        sLI_Vars[u8Bulb].sBlue.u32Current    += sLI_Vars[u8Bulb].sBlue.i32Delta;
        sLI_Vars[u8Bulb].sColTemp.u32Current += sLI_Vars[u8Bulb].sColTemp.i32Delta;
        vLI_UpdateDriver(u8Bulb);
    }
}

/****************************************************************************
 * NAME:	vLI_UpdateDriver
 *
 * DESCRIPTION:
 *			passes the LI points between previous and current
 *			ZCL updates to the colour driver for smooth transitions
 ****************************************************************************/
PUBLIC void vLI_UpdateDriver(uint8 u8Bulb)
{
	DriverBulb_vSetColour(u8Bulb,
			              sLI_Vars[u8Bulb].sRed.u32Current   >> SCALE,
			              sLI_Vars[u8Bulb].sGreen.u32Current >> SCALE,
			              sLI_Vars[u8Bulb].sBlue.u32Current  >> SCALE);

	DriverBulb_vSetLevel(u8Bulb, sLI_Vars[u8Bulb].sLevel.u32Current  >> SCALE);
}

/****************************************************************************/
/***        Local    Functions                                            ***/
/****************************************************************************/

/****************************************************************************
 * NAME:	vLI_InitVar
 *
 * DESCRIPTION:
 *	 		Initialises a single LI variable to the output(s) from
 *	        ZCL cluster, converts to big integer and calculates the adjustment
 *	        needed on each of the successive LI points
 ****************************************************************************/
PRIVATE void vLI_InitVar(tsLI_Params *psLI_Params, uint32 u32NewTarget)
{
	psLI_Params->u32Target = u32NewTarget << SCALE;

	if (psLI_Params->u32Target < psLI_Params->u32Current)
	{
		psLI_Params->i32Delta = -(u32divu10(psLI_Params->u32Current - psLI_Params->u32Target));
	}
	else
	{
		psLI_Params->i32Delta = u32divu10(psLI_Params->u32Target - psLI_Params->u32Current);;
	}
	psLI_Params->u32Current += psLI_Params->i32Delta;
}

/****************************************************************************
 * NAME:	u32divu10
 *
 * DESCRIPTION:
 *			Fast divide by 10 routine (~8 times faster than gcc "/" operator)
 ****************************************************************************/
PRIVATE uint32  u32divu10(uint32 n)
{
    uint32 q, r;
	q = (n >> 1) + (n >> 2);
	q = q + (q >> 4);
	q = q + (q >> 8);
	q = q + (q >> 16);
	q = q >> 3;
	r = n - q*10;
	return q + ((r + 6) >> 4);
}

/****************************************************************************/
/***        END OF FILE                                                   ***/
/****************************************************************************/
