phosphide/ZLL_Lights/(commit log)

2017-12-24 Adding PCA9685 driver
2017-12-25 Scaling PWM values correctly for PCA9685
    [DriverBulb_PCA9685.c]
2017-12-28 Saving scene data for all endpoints, making sure vIdEffectTick has the correct prototype as required by API
    [app_zcl_light_task.c]
2017-12-28 Making APP_ZCL_vSetIdentifyTime (mostly) per-endpoint so that identify effects go to the correct endpoint
    [app_light_commission_task.c, app_zcl_light_task.c, app_zcl_light_task.h]
2017-12-29 Improvements to PCA9685 driver
2017-12-29 Fixing bug where switching from full-off to full-on would not work
    [DriverBulb_PCA9685.c]
2018-04-22 Adjusting PWM value based on gamma/intensity
2018-05-01 Adding hardware definition files
    [ZigbeeLightController.kicad_pcb, ZigbeeLightController.sch, ZigbeeLightController_RevA0_bom.xlsx]
2018-05-06 Measuring temperature using on-board NTC thermistor
2018-05-26 Bugfix: call to APP_vHandleIdentify was using wrong parameters
    [app_light_commission_task.c]
2018-05-26 Shutting off lights if board reaches a temperature limit
2018-05-27 Adding hardware definition files for mini version
    [ZigbeeLightControllerMini.kicad_pcb, ZigbeeLightControllerMini.sch, ZigbeeLightControllerMini_RevA0_bom.xlsx]
2018-05-27 Standard hardware bugfixes: changed BOM to use correct 0603 part instead of 0402 part, widened pad for D3, changed R2 to 10k to reduce line item count, filling top layer
    [ZigbeeLightController.kicad_pcb, ZigbeeLightController.sch, ZigbeeLightController_RevA0_bom.xlsx, ZigbeeLightController_RevA1_bom.xlsx]
2018-05-27 Removing unnecessary kicad files
2018-05-28 Adding .cproject that was missed in last commit, providing dummy ISR for Timer1 to appease linker
    [DriverBulb_PCA9685.c]
2018-05-30 Bugfix: variant wasn't being set correctly
    [DriverBulb.h, app_light_calibration.c]
2018-05-30 Fixing PCB fill issue, using - and K for LED terminals
    [ZigbeeLightController.kicad_pcb, ZigbeeLightControllerMini.kicad_pcb]
